hitov/vhfrx1/doc/receiver.png

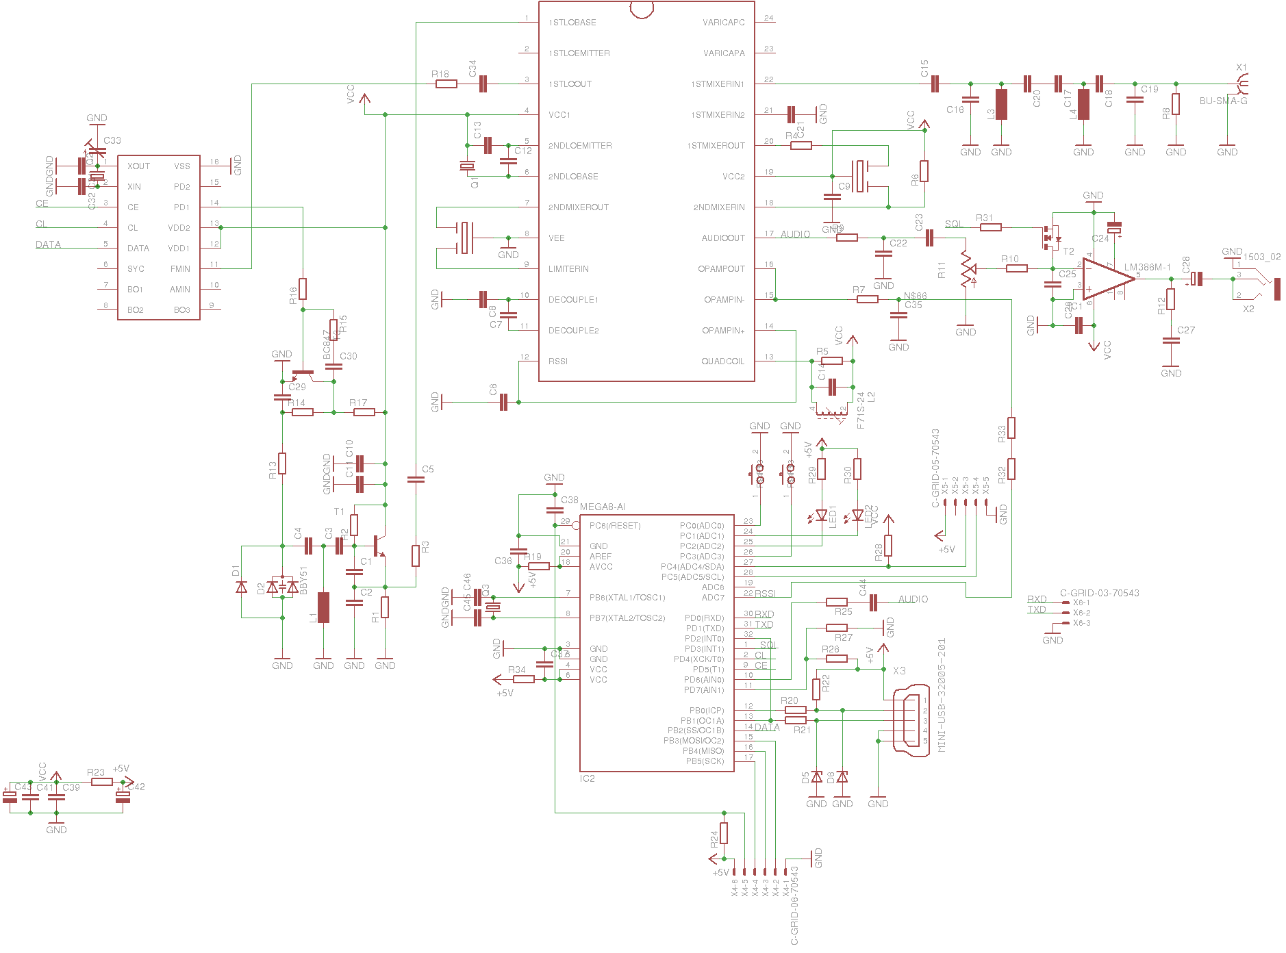
doc/receiver.png
