hitov/vhfrx1/hardware/aprstracker/aprs.pdf

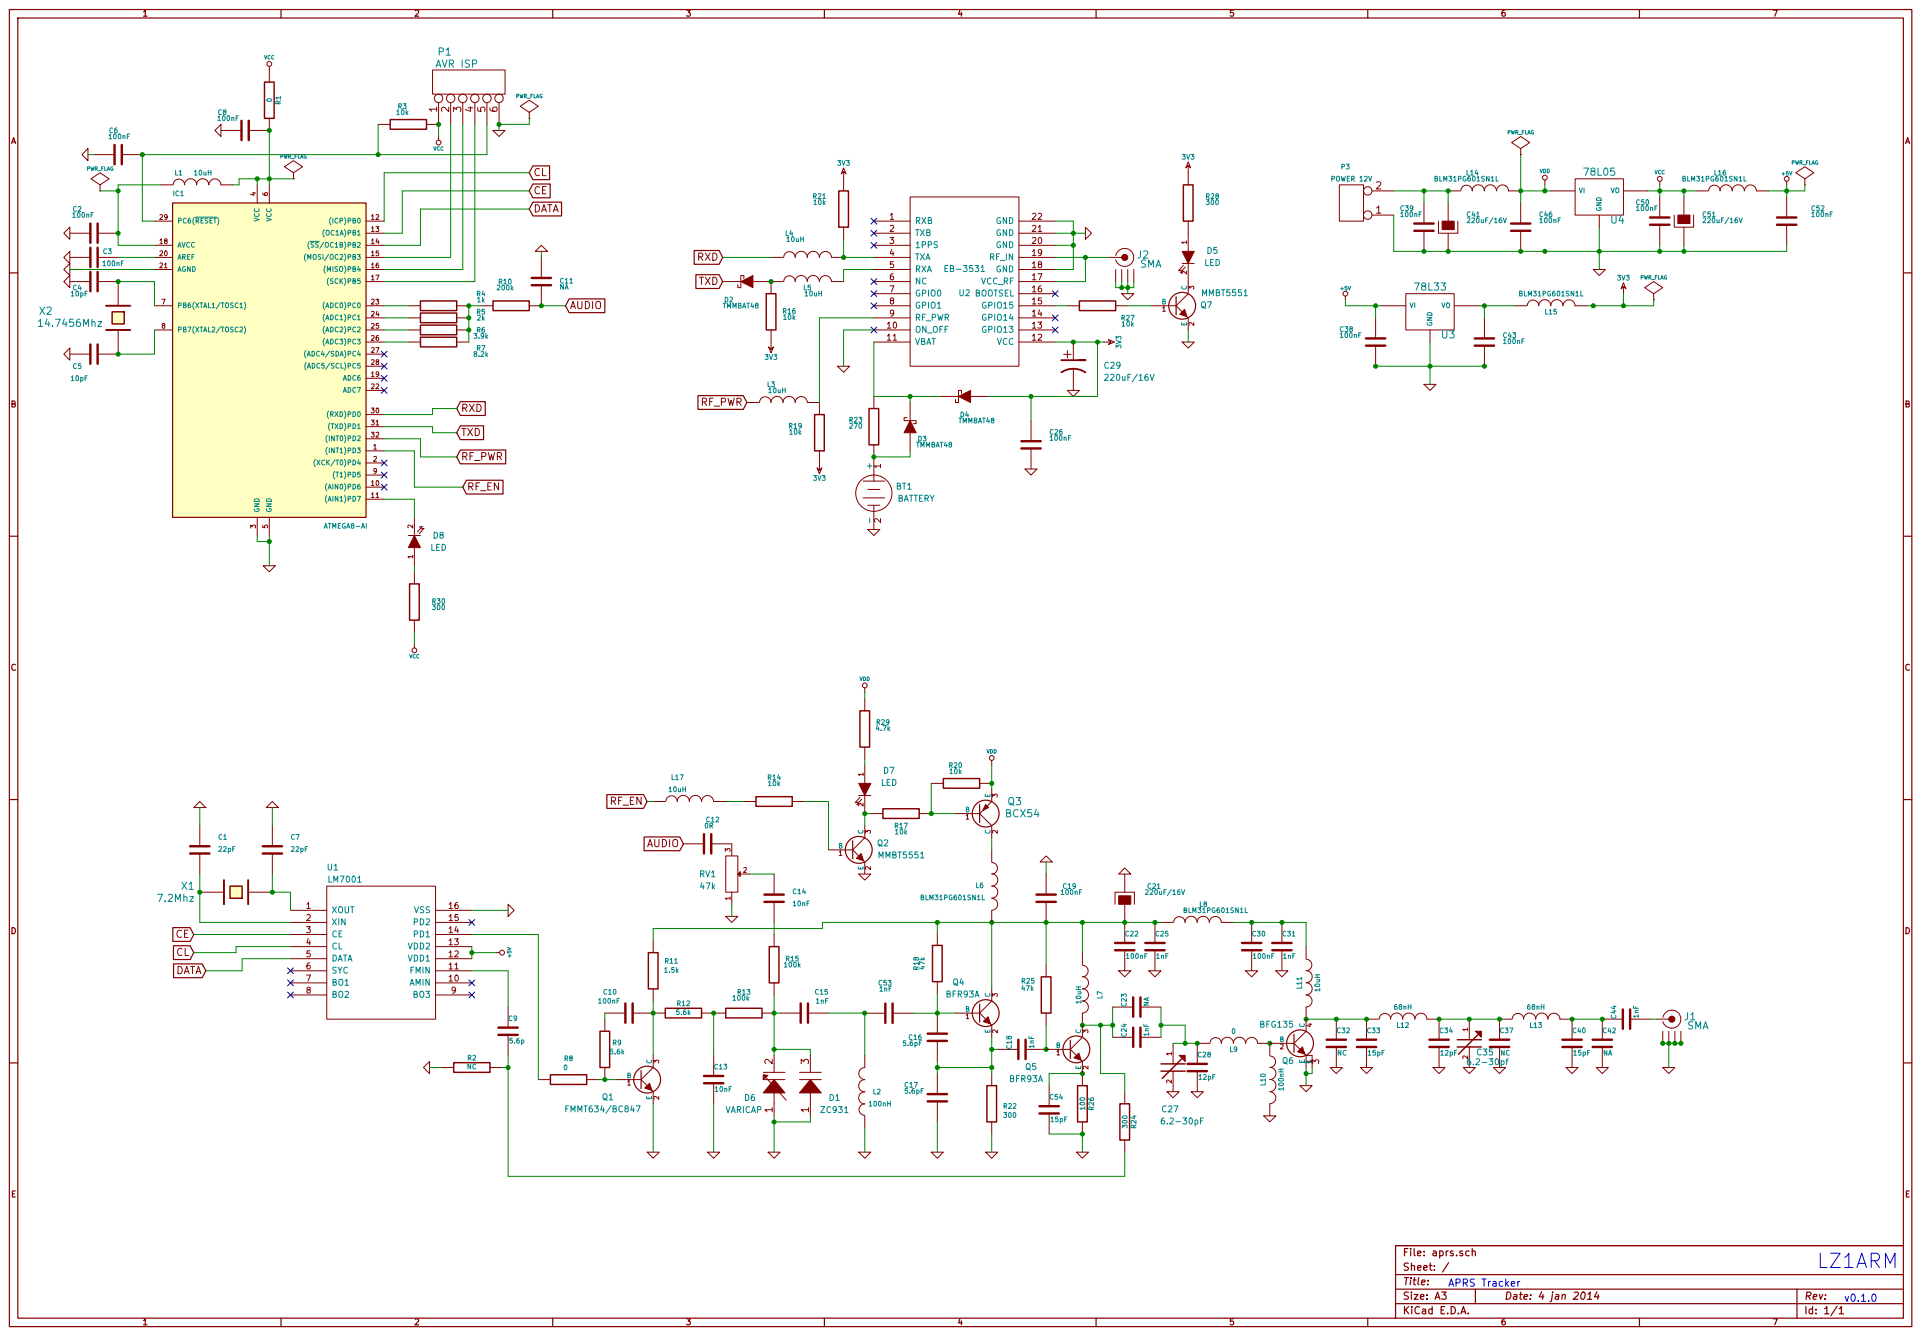
[picture p2: page 1]

Id: 1/1 Title: File: aprs.sch
