hitov/vhfrx1/hardware/simulations/tx-aprs.asc

C1: cap; 12p
C2: cap; 12p
C3: cap; 1000p
C4: cap; 12p
C5: cap; 1n
C6: cap; 10n
C7: cap; 1n
C8: cap; 15p
C9: cap; 33p
C10: cap; 15p
C11: cap; 1n
C12: cap; 5.25p
C13: cap; 15p
I1: current; SINE(0 1); AC 1
L1: ind; 100n; Rser=5
L2: ind; 10µ
L4: ind; 10µ
L5: ind; 68n; Rser=1
L6: ind; 68n; Rser=1
L7: ind; 100n
Q1: npn; BFR93AW
Q2: npn; BFR93AW
Q3: npn; BFG135
R1: res; 300
R2: res; 47K
R3: res; 100
R4: res; 10
R5: res; 47k
R7: res; 50
R8: res; 100G
V1: voltage; 7.2
Named nets: 0
* BFR93AW SPICE MODEL

* PHILIPS SEMICONDUCTORS

* Date : September 1995

*

* PACKAGE : SOT323 DIE MODEL : BFR91A

* 1: COLLECTOR; 2: BASE; 3: EMITTER

.SUBCKT BFR93AW 1 2 3

Q1 6 5 7 7 BFR91A

* SOT323 parasitic model

               Lb  4 5 .6n 

               Le  7 8 .6n

               L1  2 4 .34n

               L2  1 6 .1n

               L3  3 8 .34n

              Ccb  4 6 100f

              Cbe  4 8 2f

*

* PHILIPS SEMICONDUCTORS                                     Version:   1.0

* Filename:   BFR91A.PRM                                     Date: Feb 1992

*

.MODEL  BFR91A   NPN

+              IS = 1.32873E-015

+              BF = 1.02000E+002

+              NF = 1.00025E+000

+             VAF = 5.19033E+001

+             IKF = 8.15511E+000

+             ISE = 1.39029E-014

+              NE = 1.51292E+000

+              BR = 1.76953E+001

+              NR = 9.94038E-001

+             VAR = 3.28032E+000

+             IKR = 1.00000E+001

+             ISC = 1.04297E-015

+              NC = 1.18993E+000

+              RB = 1.00000E+001

+             IRB = 1.00000E-006

+             RBM = 1.00000E+001

+              RE = 7.63636E-001

+              RC = 9.00000E+000

+              EG = 1.11000E+000

+             XTI = 3.00000E+000

+             CJE = 2.03216E-012

+             VJE = 6.00000E-001

+             MJE = 2.90076E-001

+              TF = 6.55790E-012

+             XTF = 3.89752E+001

+             VTF = 1.09308E+001

+             ITF = 5.21078E-001

+             CJC = 1.00353E-012

+             VJC = 3.40808E-001

+             MJC = 1.94223E-001

.ENDS
.tran 500µ startup
* Filename:  BFG135_SPICE.PRM
* BFG135 SPICE MODEL
* PHILIPS SEMICONDUCTORS
* Date : September 1995
*
* PACKAGE : SOT223A DIE MODEL : BFR134
* 1: COLLECTOR; 2: BASE; 3: EMITTER;
.SUBCKT BFG135 1 2 3
Q1 6 5 7 7 BFR134
* SOT223A parasitic model
               Lb  4 5 1.5n 
               Le  7 8 .5n
               L1  2 4 .025n
               L2  1 6 1.19n
               L3  3 8 .6n
              Ccb  4 6 16f
              Cbe  4 8 182f
*
* PHILIPS SEMICONDUCTORS                                       Version:     2.0
* Filename:   BFR134.PRM                                       Date: April 1992  *
.MODEL  BFR134   NPN
+              IS = 6.26489E-015
+              BF = 1.42485E+002
+              NF = 1.00616E+000
+             VAF = 4.48500E+001
+             IKF = 4.47193E+000
+             ISE = 3.79274E-013
+              NE = 2.07719E+000
+              BR = 9.14350E+000
+              NR = 1.05535E+000
+             VAR = 3.00000E+000
+             IKR = 3.62503E-002
+             ISC = 8.32089E-017
+              NC = 1.03925E+000
+              RB = 4.00000E+000
+             IRB = 1.00000E-006
+             RBM = 4.00000E+000
+              RE = 1.19858E+000
+              RC = 1.00000E+000
+              EG = 1.11000E+000
+             XTI = 3.00000E+000
+             CJE = 6.93680E-012
+             VJE = 6.00000E-001
+             MJE = 4.07326E-001
+              TF = 1.11019E-011
+             XTF = 5.41522E+001
+             VTF = 5.75002E+000
+             ITF = 9.98036E-001
+             PTF = -2.0000E+002
+             CJC = 2.17679E-012
+             VJC = 2.78142E-001
+             MJC = 1.72323E-001
.ENDS
;ac lin 100 100000000 200000000
