hitov/vhfrx1/hardware/aprstracker/aprs.kicad_pcb

## KiCad design hardware/aprstracker/aprs.kicad_pcb (2013-12-03)

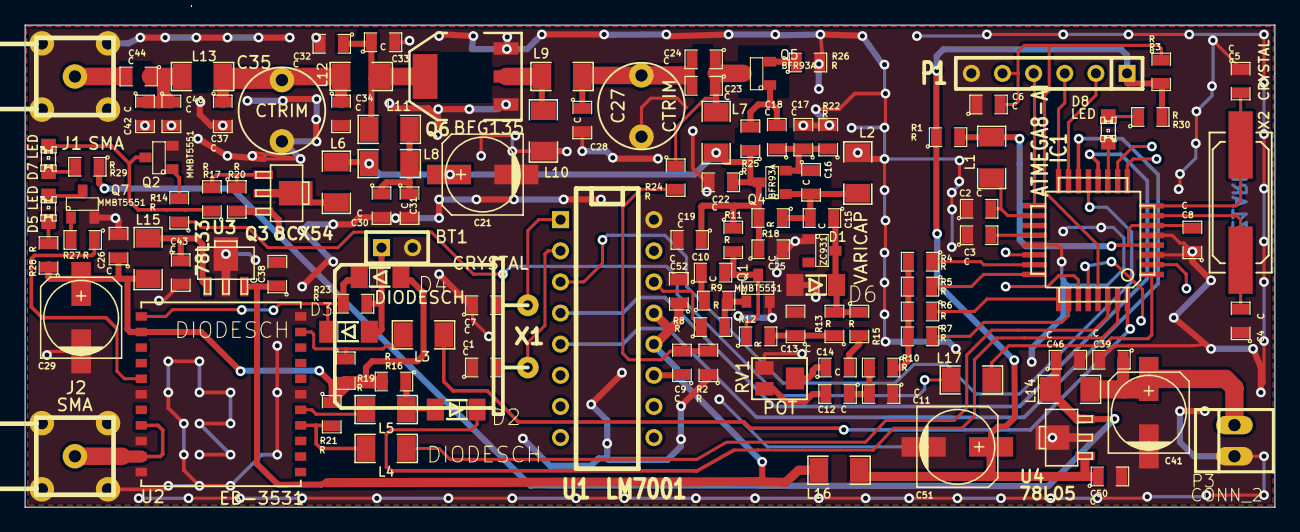
[picture p3: board aprs.kicad_pcb from above]

Board: 2 copper layers, 102.0 x 39.3 mm, 122 parts (0 on the bottom side), 74 nets.

Parts:
ASTUB: VAL**; ASTUB
BT1: BATTERY; SIL-2
C1, C2, C3, C4, C5, C6, C7, C8, C9, C10, C11, C12, C13, C14, C15, C16, C17, C18, C19, C22, C23, C24, C25, C26, C28, C30, C31, C32, C33, C34, C37, C38, C39, C40, C42, C43, C44, C46, C50, C52: C; SM0805
C21, C41, C51: CAPAPOL; c_elec_6.3x4.5
C27, C35: CTRIM; TSC6
C29: CP1; c_elec_6.3x4.5
D1: ZC931; SOT23
D2, D3, D4: DIODESCH; MiniMelf
D5, D7, D8: LED; LED-0805
D6: VARICAP; MiniMelf
IC1: ATMEGA8-AI; TQFP32
J1, J2: SMA
L1, L2, L3, L4, L5, L6, L7, L8, L9, L10, L11, L12, L13, L14, L15, L16, L17: INDUCTOR; SM1206
P1: CONN_6; SIL-6
P3: CONN_2; PINHEAD1-2
Q1, Q2, Q7: MMBT5551; SOT23
Q3: BCX54; sot89
Q4, Q5: BFR93A; SOT23
Q6: BFG135; SOT223
R1, R2, R3, R4, R5, R6, R7, R8, R9, R10, R11, R12, R13, R14, R15, R16, R17, R18, R19, R20, R21, R22, R23, R24, R25, R26, R27, R28, R29, R30: R; SM0805
RV1: POT; MVR34
U1: LM7001; DIP-16__300
U2: EB-3531
U3: 78L33; sot89
U4: 78L05; sot89
X1: CRYSTAL; HC-18UH
X2: CRYSTAL; Q_49U3HMS

Connections:
3V3: C26.1, C29.1, D4.1, L15.2, R16.2, R19.2, R21.1, R28.1, U2.12
+5V: C38.1, C52.1, L16.2, U1.12, U1.13, U3.3
AUDIO: C11.2, C12.1, R10.2
CE: IC1.13, U1.3
CL: IC1.12, U1.4
DATA: IC1.14, U1.5
GND: BT1.2, C1.1, C2.1, C3.1, C4.1, C5.1, C6.1, C7.1, C8.1, C11.1, C13.2, C17.2, C19.2, C21.2, C22.2, C25.2, C26.2, C27.2, C28.2, C29.2, C30.2, C31.2, C32.2, C33.2, C34.2, C35.2, C37.2, C38.2, C39.2, C40.2, C41.2, C42.2, C43.2, C46.2, C50.2, C51.2, C52.2, D1.1, D6.1, IC1.3, IC1.5, IC1.21, J1.2, J1.3, J1.4, J1.5, J2.2, J2.3, J2.4, J2.5, L2.1, L10.2, P1.6, P3.1, Q1.2, Q2.2, Q6.1, Q6.3, Q7.2, R2.1, R22.2, R26.2, RV1.1, U1.16, U2.10, U2.18, U2.20, U2.21, U2.22, U3.2, U4.2
unnamed: R27.1, U2.15
unnamed: Q7.1, R27.2
unnamed: L3.2, R19.1, U2.9
unnamed: C39.1, C41.1, L14.1, P3.2
unnamed: L5.2, U2.5
unnamed: L4.2, R21.2, U2.4
unnamed: D3.2, D4.2, R23.1, U2.11
unnamed: BT1.1, D3.1, R23.2
unnamed: C43.1, L15.1, U3.1
unnamed: C40.1, C42.1, C44.1, L13.2
unnamed: C23.2, C24.2, C27.1, C28.1, L9.1
unnamed: C7.2, U1.1, X1.1
unnamed: C9.1, U1.11
unnamed: C13.1, R12.2, R13.1
unnamed: Q3.1, R17.2, R20.1
unnamed: C10.1, R9.1
unnamed: R8.1, U1.14
unnamed: IC1.26, R7.1
unnamed: C5.2, IC1.8, X2.2
unnamed: IC1.23, R4.1
unnamed: IC1.24, R5.1
unnamed: IC1.25, R6.1
unnamed: C3.2, IC1.20
unnamed: L17.2, R14.1
unnamed: C14.2, R15.2
unnamed: C14.1, RV1.2
unnamed: IC1.15, P1.2
unnamed: IC1.16, P1.3
unnamed: IC1.17, P1.4
unnamed: C6.2, IC1.29, P1.5, R3.1
unnamed: C4.2, IC1.7, X2.1
unnamed: L9.2, L10.1, Q6.2
unnamed: C18.2, Q5.1, R25.2
unnamed: Q5.2, R26.1
unnamed: C15.1, D1.3, D6.2, R13.2, R15.1
unnamed: D8.1, R30.1
unnamed: D8.2, IC1.11
unnamed: C23.1, C24.1, L7.2, Q5.3, R24.1
unnamed: D5.2, Q7.3
unnamed: Q2.1, R14.2
unnamed: D7.2, Q2.3, R17.1
unnamed: D7.1, R29.2
unnamed: L6.1, Q3.2
unnamed: C44.2, J1.1
unnamed: C9.2, R2.2, R24.2
unnamed: J2.1, U2.17, U2.19
unnamed: C8.2, IC1.4, IC1.6, L1.2, R1.2
unnamed: C2.2, IC1.18, L1.1
unnamed: R4.2, R5.2, R6.2, R7.2, R10.1
unnamed: Q1.1, R8.2, R9.2
unnamed: C10.2, Q1.3, R11.2, R12.1
unnamed: C15.2, C16.2, L2.2, Q4.1, R18.1
unnamed: C16.1, C17.1, C18.1, Q4.2, R22.1
unnamed: C12.2, RV1.3
unnamed: C1.2, U1.2, X1.2
unnamed: C34.1, C35.1, C37.1, L12.2, L13.1
unnamed: C32.1, C33.1, L11.2, L12.1, Q6.4
unnamed: C19.1, C21.1, C22.1, C25.1, L6.2, L7.1, L8.1, Q4.3, R11.1, R18.2, R25.1
unnamed: C30.1, C31.1, L8.2, L11.1
unnamed: D2.1, L5.1, R16.1
unnamed: D5.1, R28.2
RF_EN: IC1.1, L17.1
RF_PWR: IC1.32, L3.1
RXD: IC1.30, L4.1
TXD: D2.2, IC1.31
VCC: C50.1, C51.1, L16.1, P1.1, R1.1, R3.2, R30.2, U4.1
VDD: C46.1, L14.2, Q3.3, R20.2, R29.1, U4.3
