hitov/vhfrx1/hardware/vhf-radio.brd

## EAGLE design hardware/vhf-radio.brd (2013-01-09)

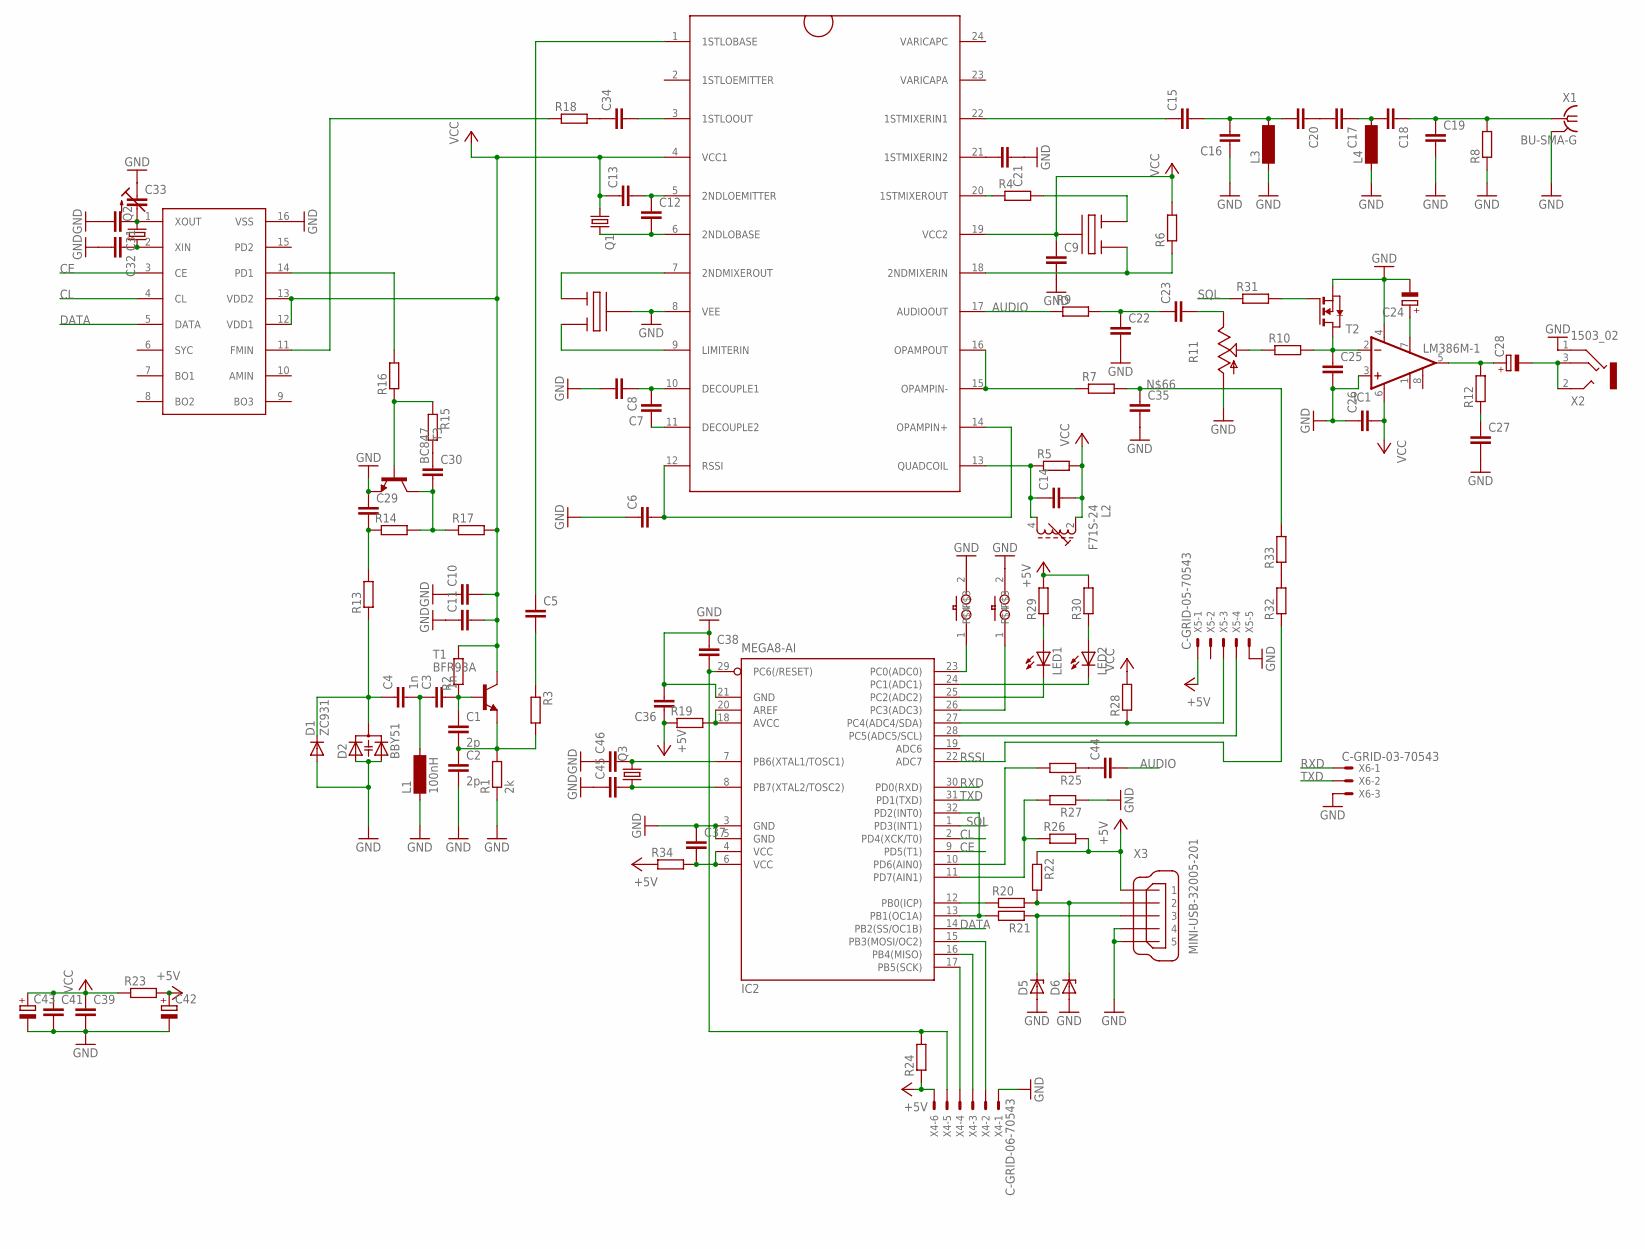
[picture p4: schematic vhf-radio.sch]

Parts:
C1, C2: 2p; C0805
C3, C4: 1n; C0805
C5, C6, C7, C8, C9, C10, C11, C12, C13, C14, C15, C16, C17, C18, C19, C20, C21, C22, C23, C25, C26, C27, C29, C30, C31, C32, C34, C35, C36, C37, C39, C41, C44, C45, C46: C-EUC0805; C0805
C24: CPOL-EU153CLV-0505; 153CLV-0505
C28: CPOL-EU153CLV-0605; 153CLV-0605
C33: C-TRIMM3018_12; CTRIM3018_12
C38: C-EU075-032X103; C075-032X103
C42, C43: CPOL-EU175TMP-0808; 175TMP-0808
D1: ZC931; MINIMELF
D2: BBY51; SOT23
D5, D6: ZENER-DIODESOD80C; SOD80C
IC1: LM386M-1; SO08
IC2: MEGA8-AI; TQFP32-08
L1: 100nH; SM-1206
L2: F71S-24; 71S
L3, L4: SM-1206
LED1, LED2: LEDCHIPLED_0805; CHIPLED_0805
Q1, Q2, Q3: CRYSTALHC49UP; HC49UP
R1: 2k; R0805
R2, R3, R4, R5, R6, R7, R8, R9, R10, R12, R13, R14, R15, R16, R17, R18, R19, R20, R21, R22, R24, R25, R26, R27, R29, R30: R-EU_R0805; R0805
R11: TRIM_US-CIP20C-6MM; CIP20C-6MM
R23, R28, R32, R33, R34: R-EU_0207/10; 0207/10
R31: R-EU_R1206; R1206
T1: BFR93A; SOT23-BEC
T2: NMOSSOT23; SOT-23
T3: BC847; SOT23
U$1: MC13135P-SMD; DIP-SMD
U$2, U$3: QFILTER; SIP3-SMD
U$4: LM7001-DIPSMD; DIP16-SMD
U$5, U$6: TS-1
X1: BU-SMA-G
X2: 1503_02
X3: MINI-USB-32005-201; 32005-201
X4: C-GRID-06-70543; 70543-06
X5: C-GRID-05-70543; 70543-05
X6: C-GRID-03-70543; 70543-03

Connections:
+5V: C36.1, C42.+, R19.1, R22.1, R23.2, R24.1, R26.2, R29.2, R30.2, R34.1, X3.1, X4.6, X5.1
AUDIO: C44.2, R9.1, U$1.17 (AUDIOOUT)
CE: IC2.9 (PD5(T1)), U$4.3 (CE)
CL: IC2.2 (PD4(XCK/T0)), U$4.4 (CL)
DATA: IC2.14 (PB2(SS/OC1B)), U$4.5 (DATA)
GND: C2.2, C6.1, C8.2, C9.2, C10.1, C11.1, C16.1, C19.2, C21.1, C22.2, C24.-, C25.2, C26.1, C27.2, C29.1, C31.2, C32.2, C33.+ (E), C35.2, C36.2, C37.1, C38.1, C39.2, C41.2, C42.-, C43.-, C45.1, C46.1, D1.A, D2.1 (A1), D2.2 (A2), D5.A, D6.A, IC1.3 (+IN), IC1.4 (GND), IC2.3 (GND), IC2.5 (GND), IC2.21 (GND), L1.1, L3.1, L4.1, R1.1, R8.1, R11.A, R27.1, T2.2 (S), T3.2 (E), U$1.8 (VEE), U$2.P$2 (2), U$4.16 (VSS), U$5.2, U$6.2, X1.2 (GND), X1.3 (GND), X1.4 (GND), X1.5 (GND), X2.1, X3.4, X3.5, X4.1, X5.5, X6.3
unnamed: C1.2, C2.1, R1.2, R3.2, T1.E
unnamed: C1.1, C3.2, R2.1, T1.B
unnamed: C5.2, R3.1
unnamed: C3.1, C4.2, L1.2
unnamed: R16.2, U$4.14 (PD1)
unnamed: C5.1, U$1.1 (1STLOBASE)
unnamed: C6.2, U$1.12 (RSSI), U$1.14 (OPAMPIN+)
unnamed: U$1.7 (2NDMIXEROUT), U$2.P$1 (1)
unnamed: U$1.9 (LIMITERIN), U$2.P$3 (3)
unnamed: C14.1, L2.4 (E), R5.1, U$1.13 (QUADCOIL)
unnamed: C12.2, Q1.2, U$1.6 (2NDLOBASE)
unnamed: R4.1, U$1.20 (1STMIXEROUT)
unnamed: R4.2, U$3.P$3 (3)
unnamed: R6.1, U$1.18 (2NDMIXERIN), U$3.P$1 (1)
unnamed: C12.1, C13.2, U$1.5 (2NDLOEMITTER)
unnamed: C15.2, C16.2, C20.2, L3.2
unnamed: C7.1, U$1.11 (DECOUPLE2)
unnamed: C7.2, C8.1, U$1.10 (DECOUPLE1)
unnamed: R7.1, U$1.15 (OPAMPIN-), U$1.16 (OPAMPOUT)
unnamed: C21.2, U$1.21 (1STMIXERIN2)
unnamed: C15.1, U$1.22 (1STMIXERIN1)
unnamed: C45.2, IC2.8 (PB7(XTAL2/TOSC2)), Q3.1
unnamed: C17.2, C20.1
unnamed: C17.1, C18.2, L4.2
unnamed: C18.1, C19.1, R8.2, X1.1
unnamed: C22.1, C23.1, R9.2
unnamed: C23.2, R11.E
unnamed: R10.1, R11.S
unnamed: C25.1, IC1.2 (-IN), R10.2, T2.1 (D)
unnamed: C24.+, IC1.7 (BYPASS)
unnamed: C29.2, R13.2, R14.1
unnamed: C27.1, R12.1
unnamed: C28.+, IC1.5 (OUT), R12.2
unnamed: C28.-, X2.2, X2.3
unnamed: C30.2, R14.2, R17.1, T3.3 (C)
unnamed: R15.1, R16.1, T3.1 (B)
unnamed: C30.1, R15.2
unnamed: C31.1, C33.- (A), Q2.2, U$4.1 (XOUT)
unnamed: IC2.18 (AVCC), IC2.20 (AREF), R19.2
unnamed: C32.1, Q2.1, U$4.2 (XIN)
unnamed: C34.1, R18.2
unnamed: C34.2, U$1.3 (1STLOOUT)
unnamed: R18.1, U$4.11 (FMIN)
unnamed: C4.1, D1.C, D2.3 (C), R13.1
unnamed: IC2.13 (PB1(OC1A)), IC2.32 (PD2(INT0)), R21.2
unnamed: IC2.12 (PB0(ICP)), R20.1
unnamed: D6.C, R20.2, R22.2, X3.2
unnamed: D5.C, R21.1, X3.3
unnamed: IC2.15 (PB3(MOSI/OC2)), X4.2
unnamed: IC2.16 (PB4(MISO)), X4.3
unnamed: IC2.17 (PB5(SCK)), X4.4
unnamed: C38.2, IC2.29 (PC6(/RESET)), R24.2, X4.5
unnamed: C44.1, R25.1
unnamed: IC2.10 (PD6(AIN0)), R25.2
unnamed: IC2.11 (PD7(AIN1)), R26.1, R27.2
unnamed: C46.2, IC2.7 (PB6(XTAL1/TOSC1)), Q3.2
unnamed: IC2.27 (PC4(ADC4/SDA)), R28.1, X5.3
unnamed: IC2.28 (PC5(ADC5/SCL)), X5.4
unnamed: IC2.25 (PC2(ADC2)), LED1.C
unnamed: IC2.24 (PC1(ADC1)), LED2.C
unnamed: LED1.A, R29.1
unnamed: LED2.A, R30.1
unnamed: IC2.23 (PC0(ADC0)), U$5.1
unnamed: IC2.26 (PC3(ADC3)), U$6.1
unnamed: R31.2, T2.3 (G)
unnamed: C35.1, R7.2, R33.2
unnamed: R32.2, R33.1
unnamed: C37.2, IC2.4 (VCC), IC2.6 (VCC), R34.2
RSSI: IC2.22 (ADC7), R32.1
RXD: IC2.30 (PD0(RXD)), X6.1
SQL: IC2.1 (PD3(INT1)), R31.1
TXD: IC2.31 (PD1(TXD)), X6.2
VCC: C9.1, C10.2, C11.2, C13.1, C14.2, C26.2, C39.1, C41.1, C43.+, IC1.6 (VS), L2.2 (A), Q1.1, R2.2, R5.2, R6.2, R17.2, R23.1, R28.2, T1.C, U$1.4 (VCC1), U$1.19 (VCC2), U$3.P$2 (2), U$4.12 (VDD1), U$4.13 (VDD2)

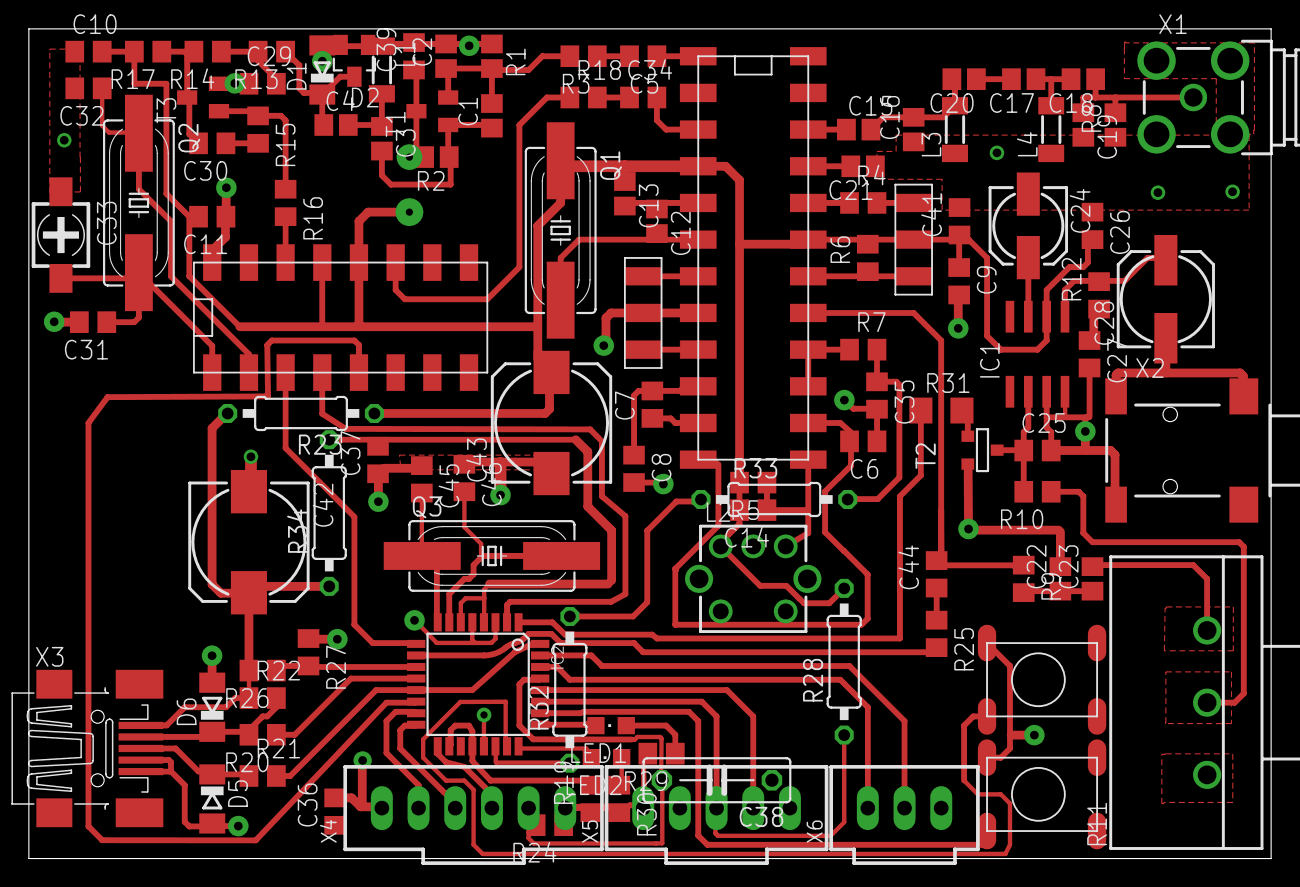
[picture p5: board vhf-radio.brd from above]

Board: 2 copper layers, 86.0 x 57.5 mm, 109 parts (0 on the bottom side), 79 nets.
