hitov/vhfrx1/(commit log)

2013-01-09 VHF Radio - Initial commit
    [vhf-radio.brd, vhf-radio.sch]
2013-01-09 LEDS On
2013-01-09 Make Leds to blink
2013-05-11 Add lm7001 driver (initial non tested)
2013-05-11 LM7001 driver update and build conditions
2013-05-26 [HW] New schematics for aprs tracker
    [aprs.sch]
2013-05-27 [HW] Update schematics
    [aprs.sch]
2013-05-31 [HW] Schematic update
    [aprs.sch]
2013-05-31 [HW] Kicad project adjustments
    [aprs.sch]
2013-06-03 [HW] Schematics/footprints update
    [aprs.sch]
2013-06-04 [HW] Update pcb, rearrange components
    [aprs.kicad_pcb, aprs.sch]
2013-11-24 [HW] Add uncommited changes / PCB updates
    [aprs.kicad_pcb, aprs.sch]
2013-11-24 [HW] route pcb
    [aprs.kicad_pcb]
2013-11-27 [HW] PCB Ground plane update
    [aprs.kicad_pcb]
2013-11-30 [HW] Fix GPS footprint and pcb
    [aprs.kicad_pcb]
2013-11-30 [HW] PCB - rearrange designators
    [aprs.kicad_pcb]
2013-11-30 [HW] PCB - minor adjustments
    [aprs.kicad_pcb]
2013-11-30 [HW] PCB - Fix DRC errors
    [aprs.kicad_pcb]
2013-12-02 [HW] Update pcb/sch/gps
    [aprs.kicad_pcb, aprs.sch]
2013-12-03 [HW] Add schematics values
    [aprs.sch]
2013-12-03 [HW] Update schematics element values, add .gitignore rules, add files
    [aprs-B_Cu.gbl, aprs-B_Mask.gbs, aprs-B_Paste.gbp, aprs-B_SilkS.gbo, aprs-Cmts_User.gbr, aprs-Dwgs_User.gbr, aprs-Eco1_User.gbr, aprs-Eco2_User.gbr]
2013-12-08 [HW] - Fix schematics of collpits oscillator and add values
    [aprs.sch]
2013-12-15 [HW] Update schematic elements values
    [aprs.sch]
2013-12-15 [HW] Update values. Add capacitor to suppress negative feedback
    [aprs.csv, aprs.sch]
2014-01-04 Update sch elements values
    [aprs.sch]
2014-01-04 [HW] Generate schematics pdf file
2014-01-04 [HW] Fix element values
    [aprs.sch]
